eYSIP-2018/CNC-for-GrowBox/Codes_for_cnc/Codes_for_cnc/greenbox1.png

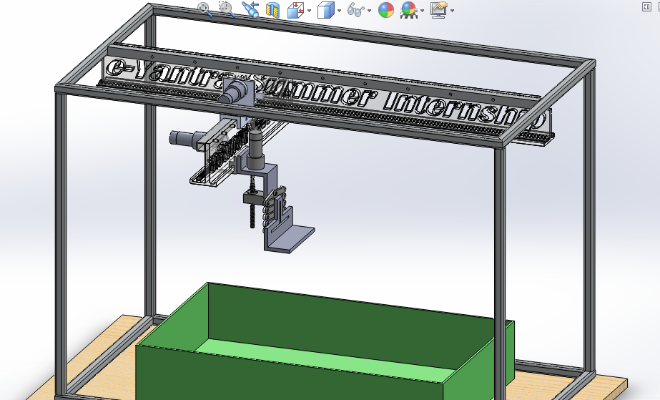
Codes_for_cnc/Codes_for_cnc/greenbox1.png
