eYSIP-2018/CNC-for-GrowBox/Codes_for_cnc/Codes_for_cnc/img03.jpg

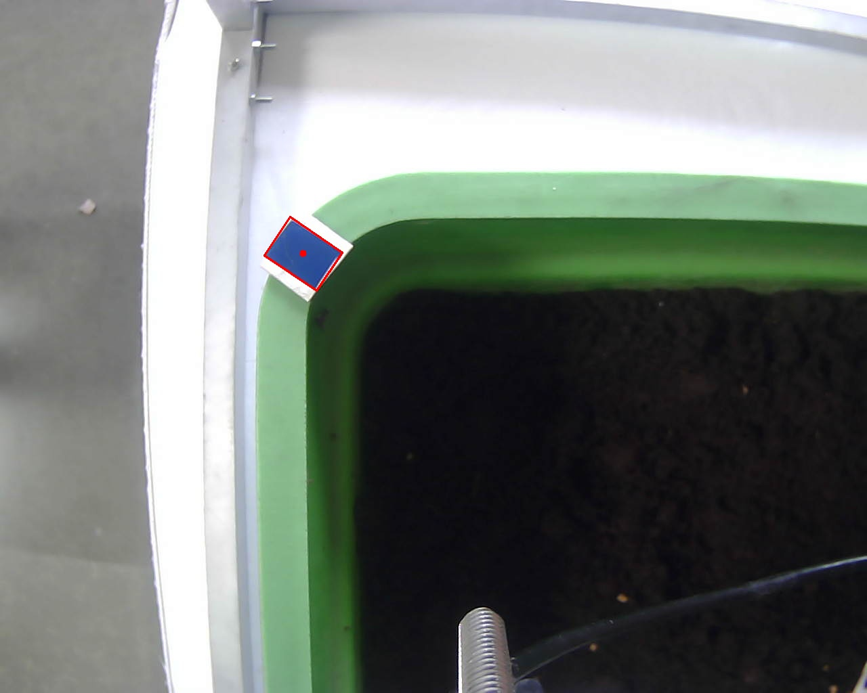
Codes_for_cnc/Codes_for_cnc/img03.jpg
