eYSIP-2018/CNC-for-GrowBox/final design/full assembly_v1.SLDASM

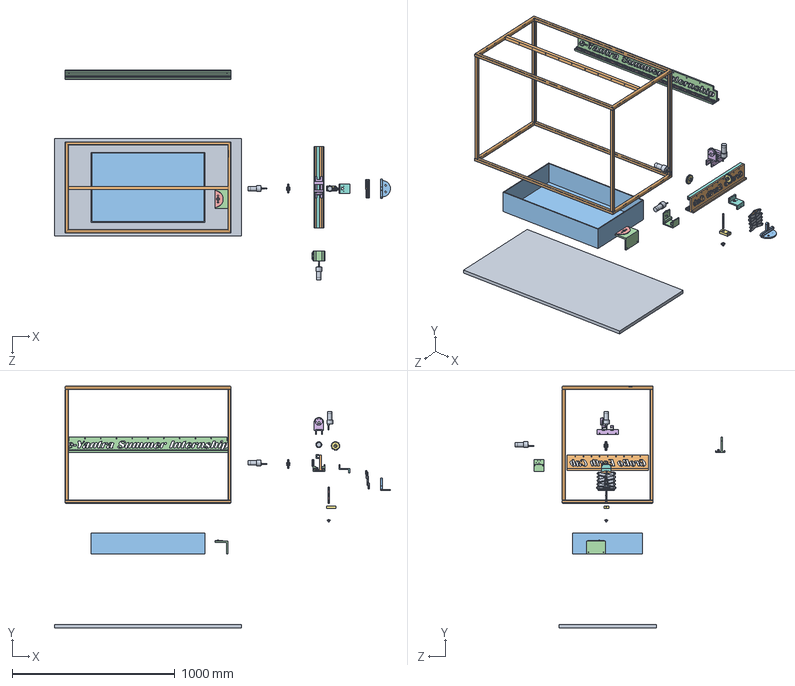
[picture p24: CAD file, 2018-07-06]
final design/full assembly_v1.SLDASM
2065.1 x 1485.8 x 1292.5 mm
floor
stand
trough
rail_x
Rack_x
servo_,mounting_x
pinion x 2
y_st_member
johnson motor x 3
rail_y
Rack_y
servo_,mounting_y
leadscrew
LeadScrew Nut 8mm x 2mmPitch
leadscrew nut attachment
attachment
link x 8
short link x 2
tool head
tool holder
watering tool
sprinkling plate
