eYSIP-2018/CNC-for-GrowBox/final design/fixed link.SLDPRT

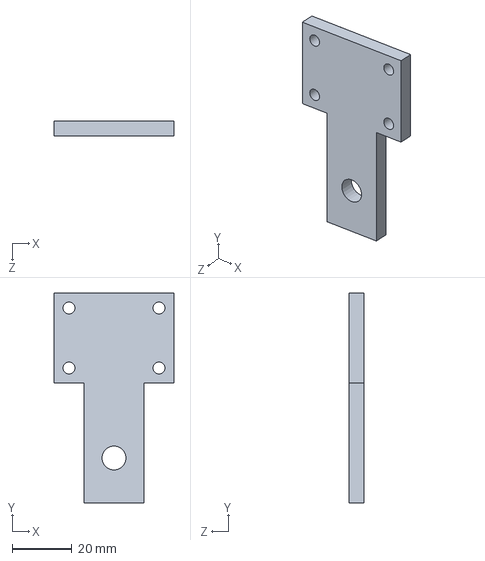
[picture p25: CAD file, 2018-07-06]
final design/fixed link.SLDPRT
40.0 x 70.0 x 5.00 mm
