eYSIP-2018/CNC-for-GrowBox/final design/Laser cutting/5_mm_changable.DXF

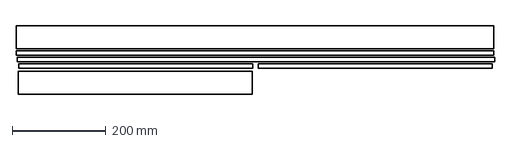
[picture p26: CAD file, 2018-07-06]
final design/Laser cutting/5_mm_changable.DXF
1022.3 x 147.4 mm
