eYSIP-2018/CNC-for-GrowBox/final design/Laser cutting/10_mm_y.SLDPRT

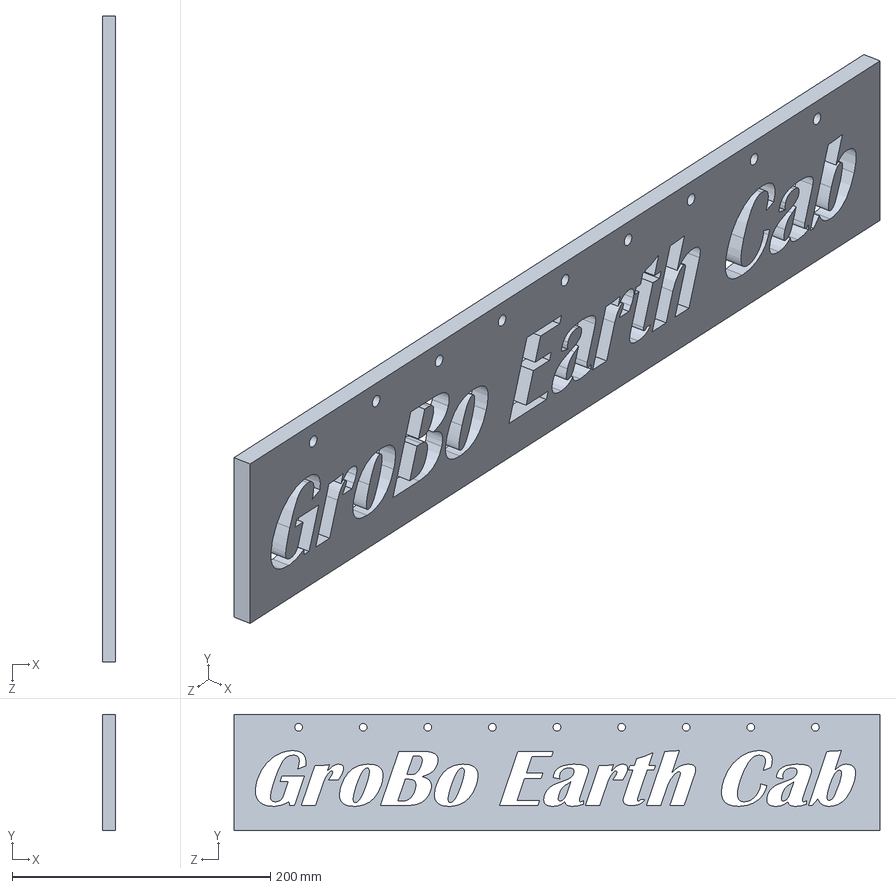
[picture p27: CAD file, 2018-07-06]
final design/Laser cutting/10_mm_y.SLDPRT
10.0 x 90.0 x 500.0 mm
