eYSIP-2018/CNC-for-GrowBox/final design/servo_,mounting_y.SLDPRT

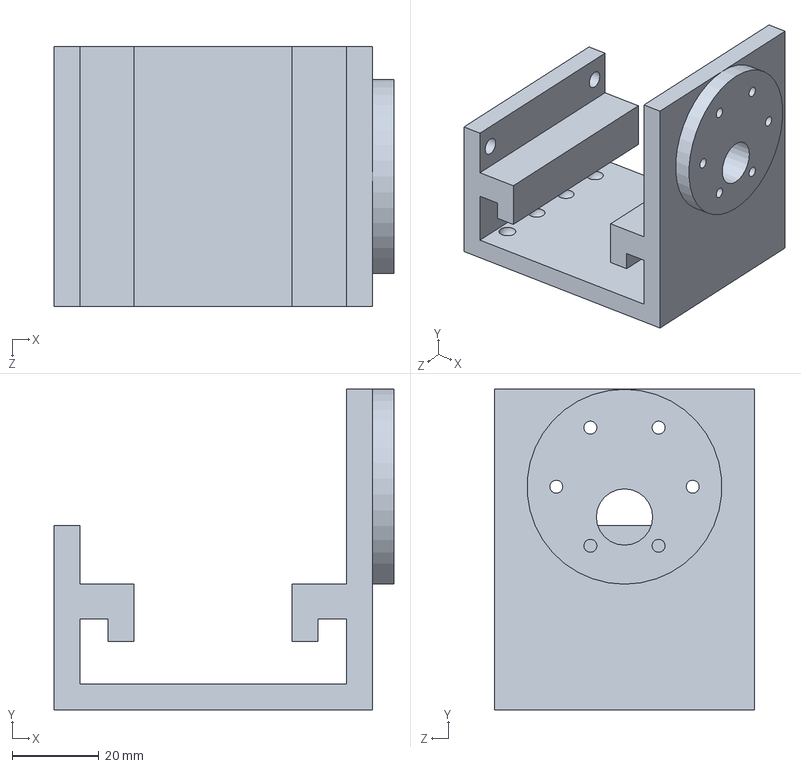
[picture p28: CAD file, 2018-07-06]
final design/servo_,mounting_y.SLDPRT
78.5 x 74.0 x 60.0 mm
