eYSIP-2018/CNC-for-GrowBox/final design/Laser cutting/Rack_y.SLDPRT

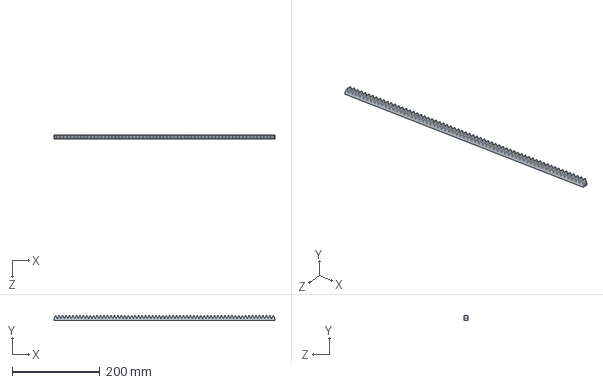
[picture p29: CAD file, 2018-07-06]
final design/Laser cutting/Rack_y.SLDPRT
502.7 x 11.2 x 10.0 mm
