eYSIP-2018/CNC-for-GrowBox/final design/tool holder.SLDPRT

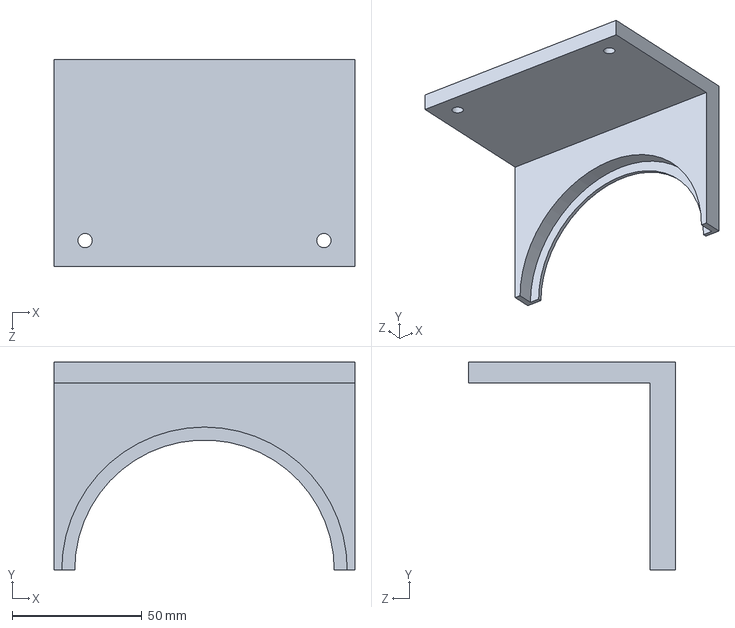
[picture p30: CAD file, 2018-07-06]
final design/tool holder.SLDPRT
116.0 x 80.0 x 79.8 mm
