eYSIP-2018/CNC-for-GrowBox/final design/Laser cutting/5mm_y_2.SLDPRT

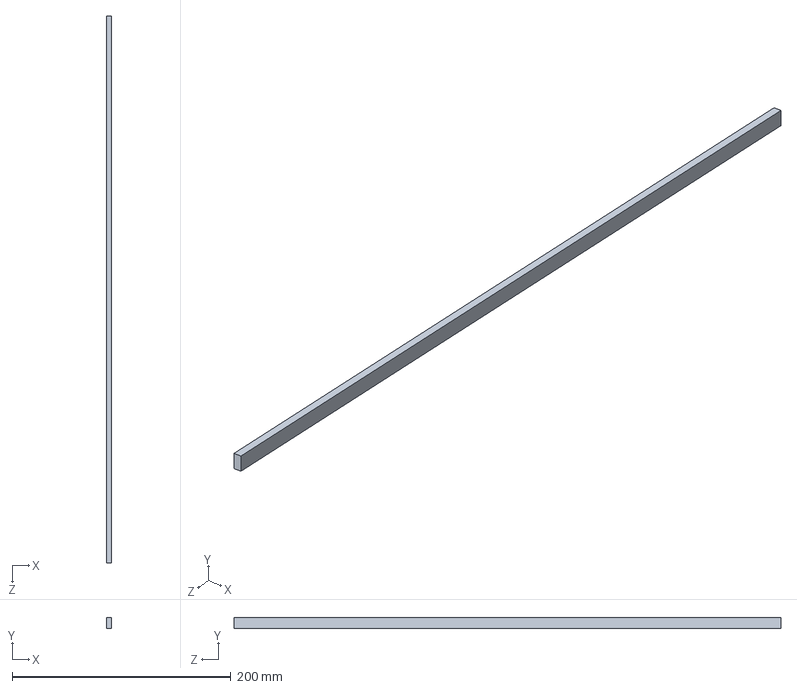
[picture p31: CAD file, 2018-07-06]
final design/Laser cutting/5mm_y_2.SLDPRT
5.00 x 10.0 x 500.0 mm
