eYSIP-2018/CNC-for-GrowBox/final design/male small link.SLDPRT

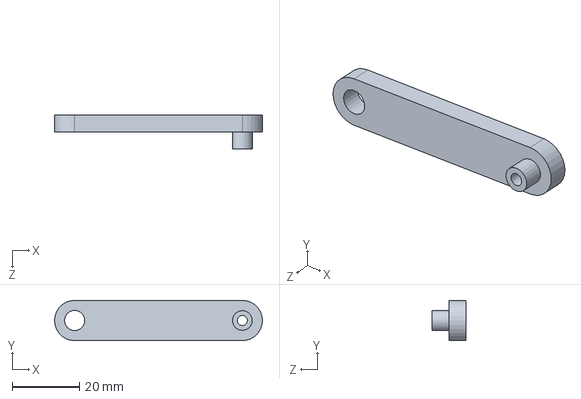
[picture p32: CAD file, 2018-07-06]
final design/male small link.SLDPRT
62.0 x 12.0 x 10.0 mm
