eYSIP-2018/CNC-for-GrowBox/final design/Laser cutting/10_mm_changable.DXF

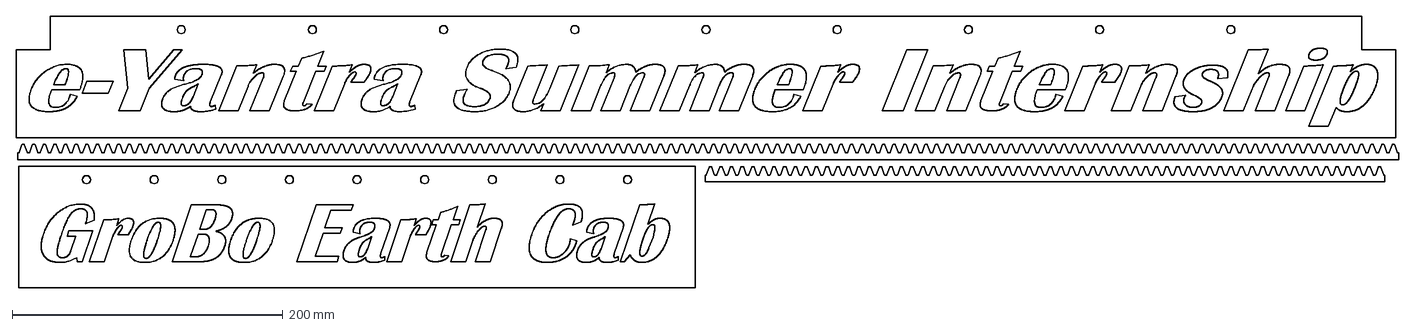
[picture p33: CAD file, 2018-07-06]
final design/Laser cutting/10_mm_changable.DXF
1022.2 x 200.9 mm
