eYSIP-2018/CNC-for-GrowBox/final design/watering tool.SLDPRT

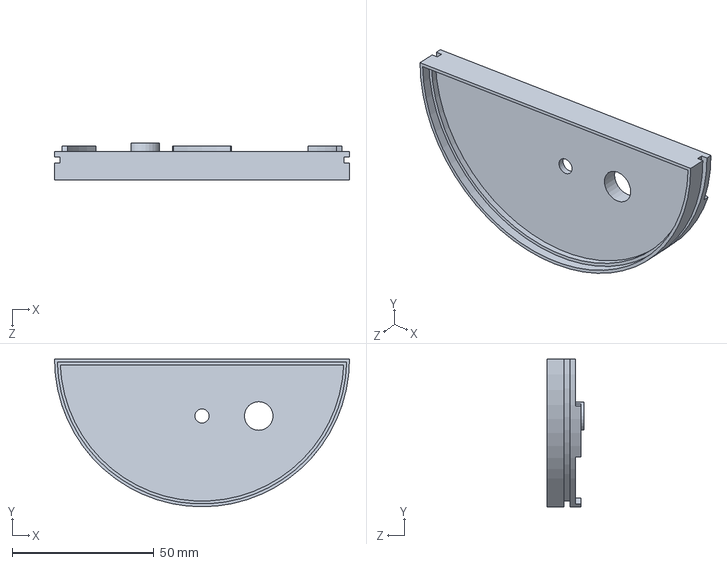
[picture p34: CAD file, 2018-07-06]
final design/watering tool.SLDPRT
104.0 x 52.0 x 13.0 mm
