eYSIP-2018/CNC-for-GrowBox/final design/Laser cutting/5_mm_final.DXF

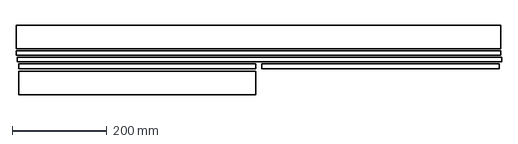
[picture p35: CAD file, 2018-07-06]
final design/Laser cutting/5_mm_final.DXF
1022.3 x 147.4 mm
