eYSIP-2018/CNC-for-GrowBox/final design/Laser cutting/10_mm_x.SLDPRT

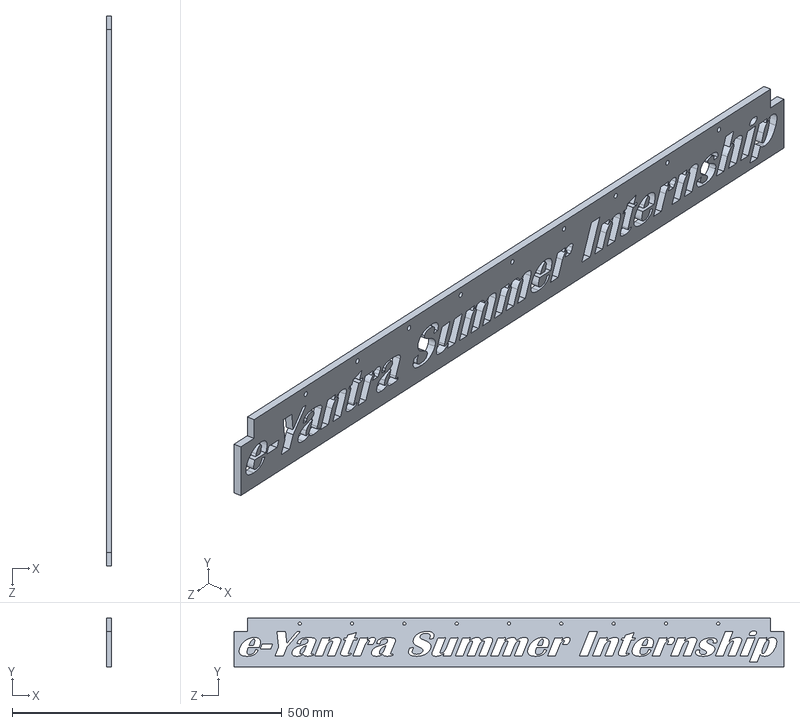
[picture p36: CAD file, 2018-07-06]
final design/Laser cutting/10_mm_x.SLDPRT
10.0 x 90.0 x 1020.0 mm
