eYSIP-2018/CNC-for-GrowBox/final design/Laser cutting/5_mm_x_2.SLDPRT

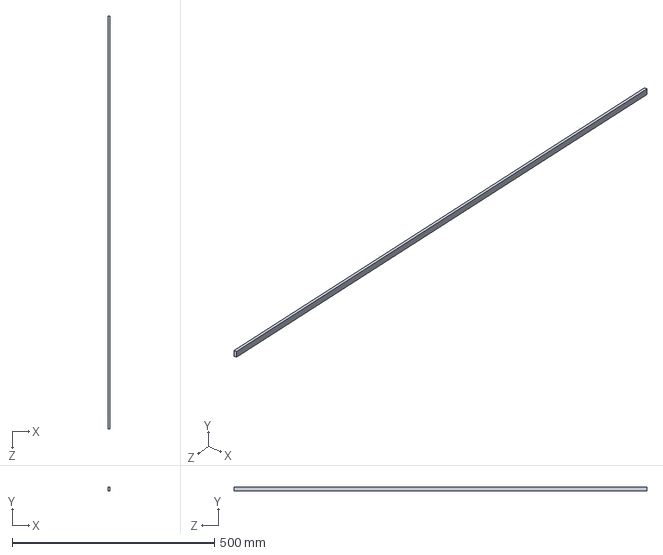
[picture p37: CAD file, 2018-07-06]
final design/Laser cutting/5_mm_x_2.SLDPRT
5.00 x 10.0 x 1020.0 mm
