eYSIP-2018/CNC-for-GrowBox/final design/pinion.SLDPRT

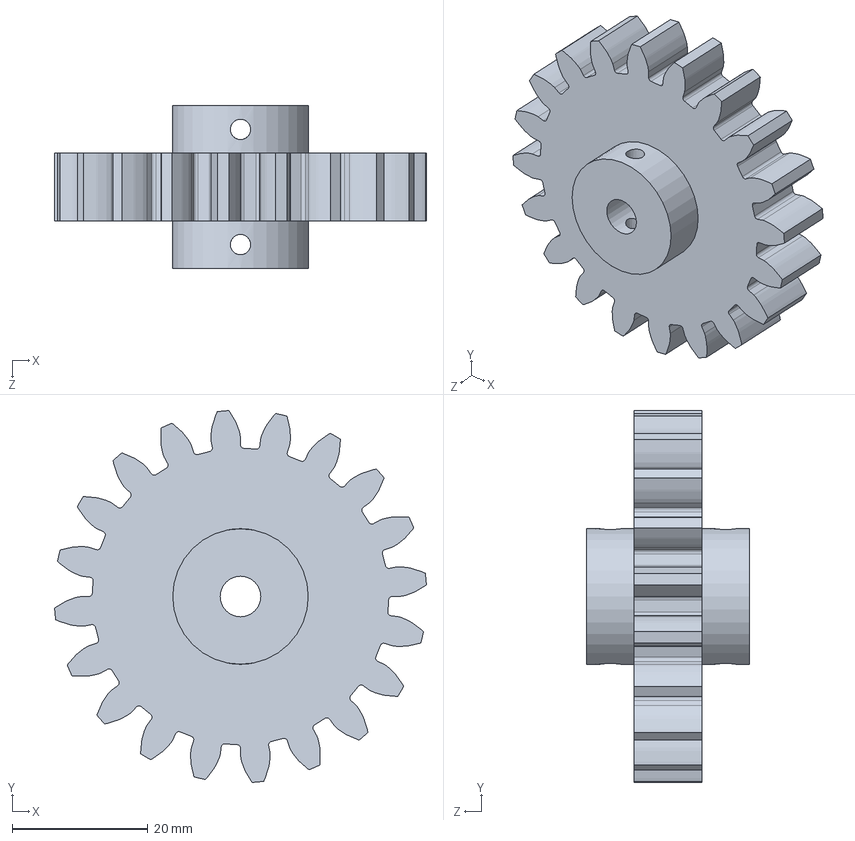
[picture p38: CAD file, 2018-07-06]
final design/pinion.SLDPRT
54.9 x 54.9 x 24.0 mm
