eYSIP-2018/CNC-for-GrowBox/final design/Laser cutting/Rack_x.SLDPRT

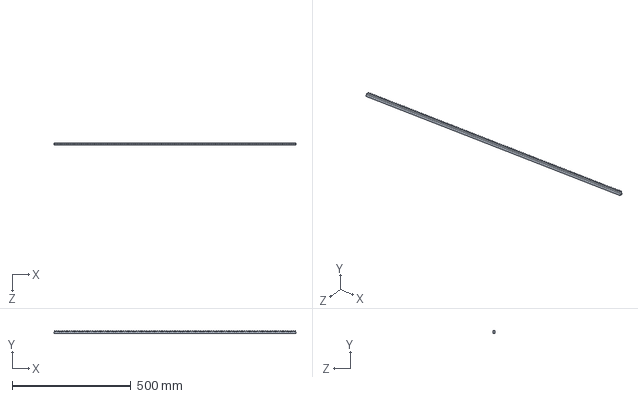
[picture p39: CAD file, 2018-07-06]
final design/Laser cutting/Rack_x.SLDPRT
1021.0 x 11.2 x 10.0 mm
