eYSIP-2018/CNC-for-GrowBox/final design/Laser cutting/5_mm_x_1.SLDPRT

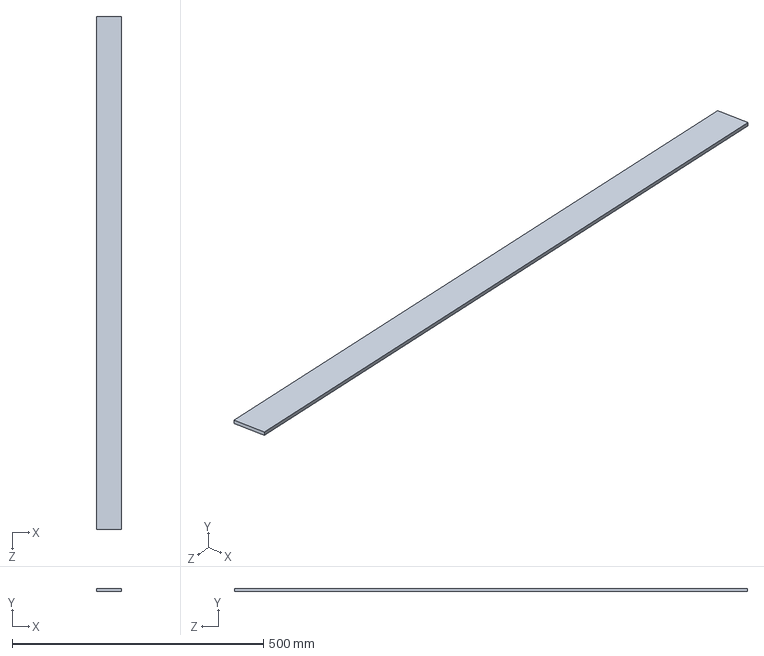
[picture p40: CAD file, 2018-07-06]
final design/Laser cutting/5_mm_x_1.SLDPRT
50.0 x 5.00 x 1020.0 mm
