eYSIP-2018/CNC-for-GrowBox/final design/male link.SLDPRT

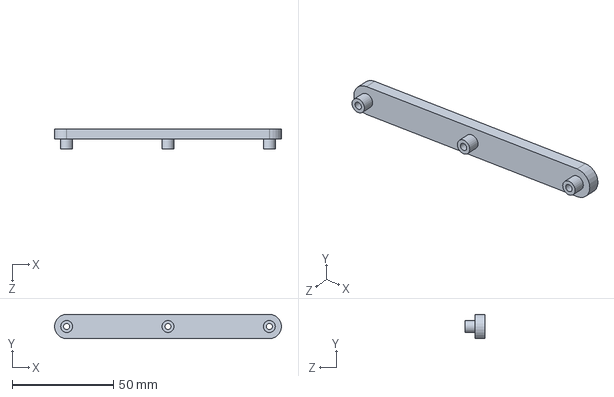
[picture p41: CAD file, 2018-07-06]
final design/male link.SLDPRT
112.0 x 12.0 x 10.0 mm
