eYSIP-2018/CNC-for-GrowBox/final design/Laser cutting/5mm_y_1.SLDPRT

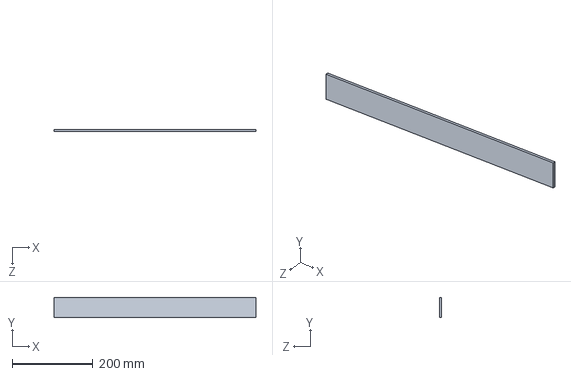
[picture p42: CAD file, 2018-07-06]
final design/Laser cutting/5mm_y_1.SLDPRT
500.0 x 50.0 x 5.00 mm
