eYSIP-2018/CNC-for-GrowBox/final design/stand.SLDPRT

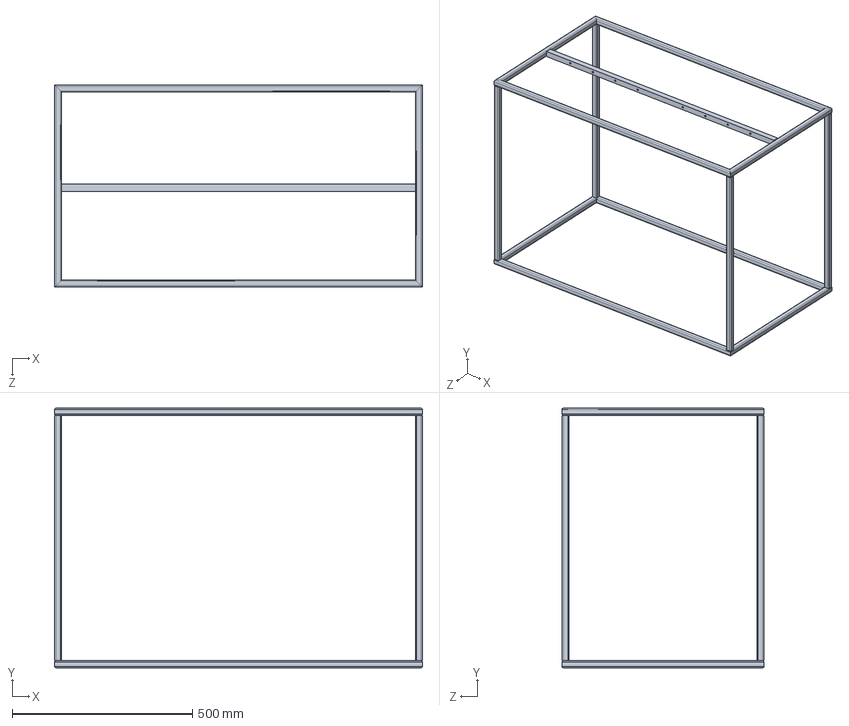
[picture p43: CAD file, 2018-07-06]
final design/stand.SLDPRT
1020.0 x 720.0 x 560.0 mm
