eYSIP-2018/CNC-for-GrowBox/final design/johnson motor.SLDPRT

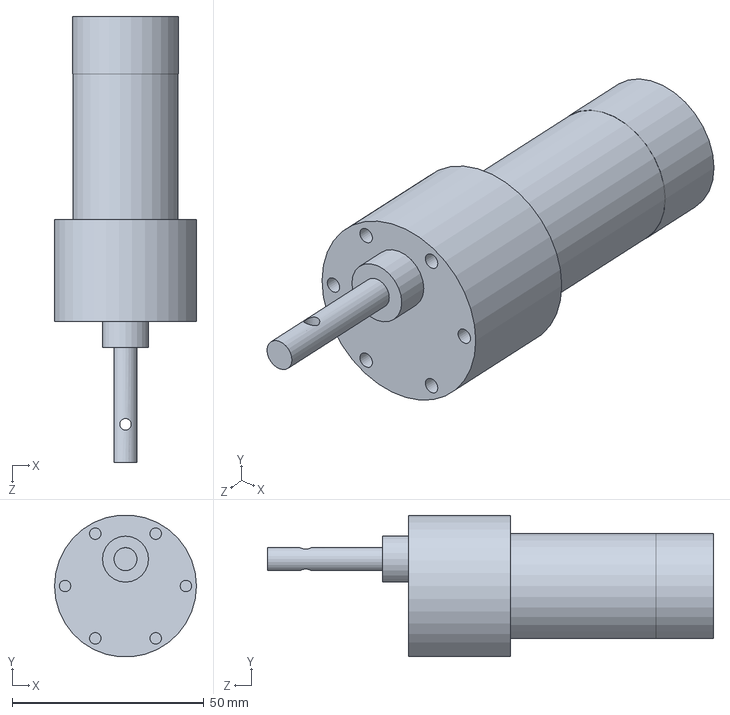
[picture p44: CAD file, 2018-07-06]
final design/johnson motor.SLDPRT
37.0 x 36.8 x 116.3 mm
