eYSIP-2018/CNC-for-GrowBox/final design/Laser cutting/scissors arm links.DXF

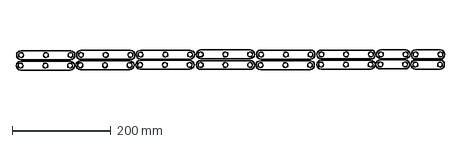
[picture p45: CAD file, 2018-07-06]
final design/Laser cutting/scissors arm links.DXF
866.7 x 41.1 mm
