eYSIP-2018/CNC-for-GrowBox/final design/floor.SLDPRT

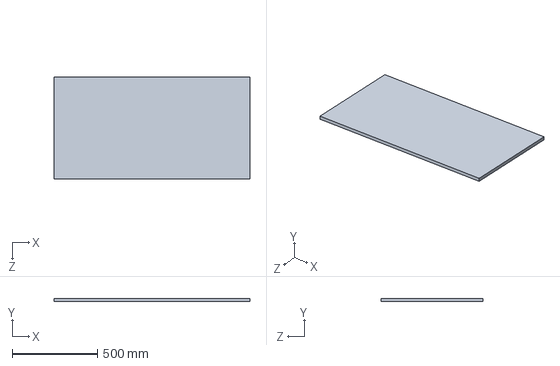
[picture p46: CAD file, 2018-07-06]
final design/floor.SLDPRT
1150.0 x 20.0 x 600.0 mm
