eYSIP-2018/CNC-for-GrowBox/final design/Laser cutting/10_mm_final.DXF

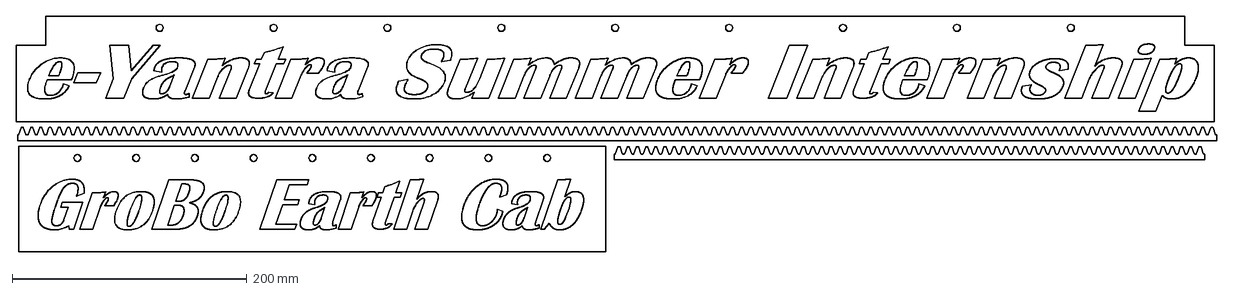
[picture p47: CAD file, 2018-07-06]
final design/Laser cutting/10_mm_final.DXF
1022.2 x 200.9 mm
