eYSIP-2018/CNC-for-GrowBox/final design/tool head.SLDPRT

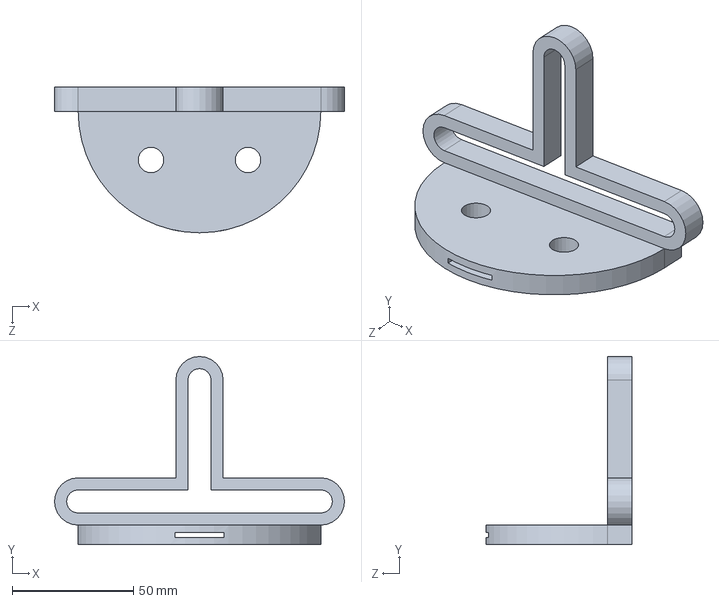
[picture p48: CAD file, 2018-07-06]
final design/tool head.SLDPRT
119.5 x 77.5 x 60.0 mm
