eYSIP-2018/CNC-for-GrowBox/final design/link.SLDPRT

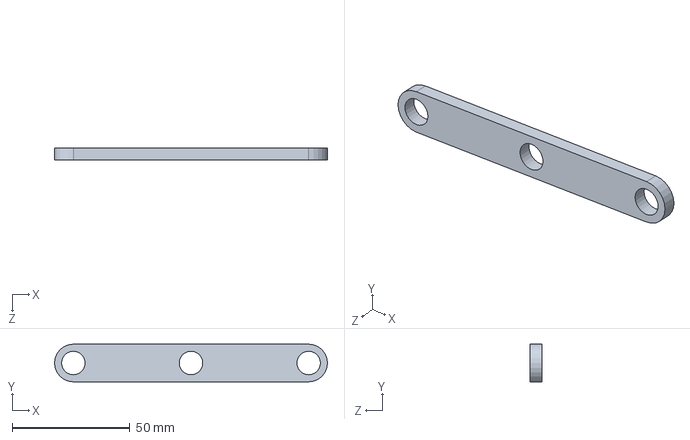
[picture p49: CAD file, 2018-07-06]
final design/link.SLDPRT
116.0 x 16.0 x 5.00 mm
