eYSIP-2018/CNC-for-GrowBox/final design/rail_y.SLDPRT

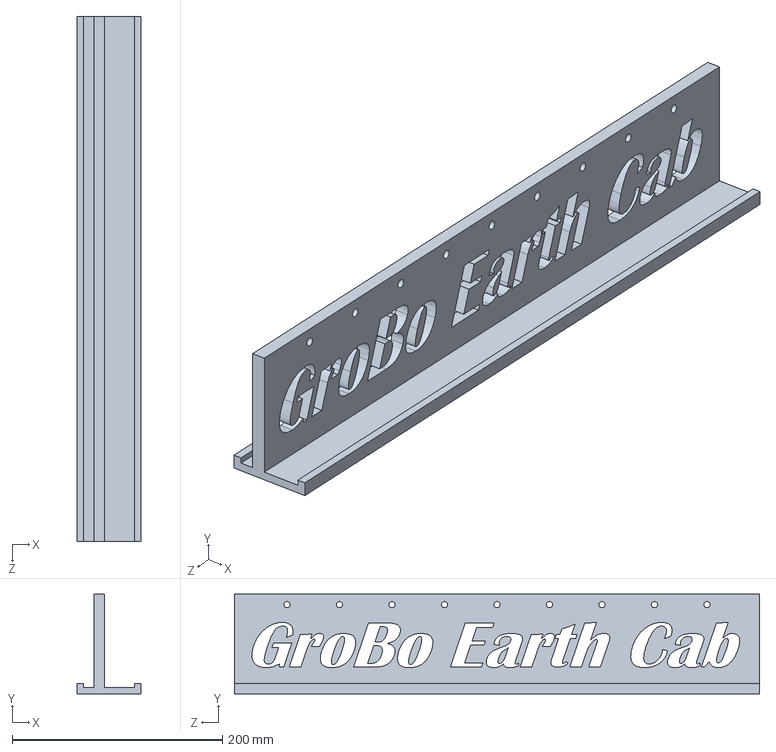
[picture p50: CAD file, 2018-07-06]
final design/rail_y.SLDPRT
60.8 x 95.0 x 500.0 mm
