eYSIP-2018/CNC-for-GrowBox/final design/trough.SLDPRT

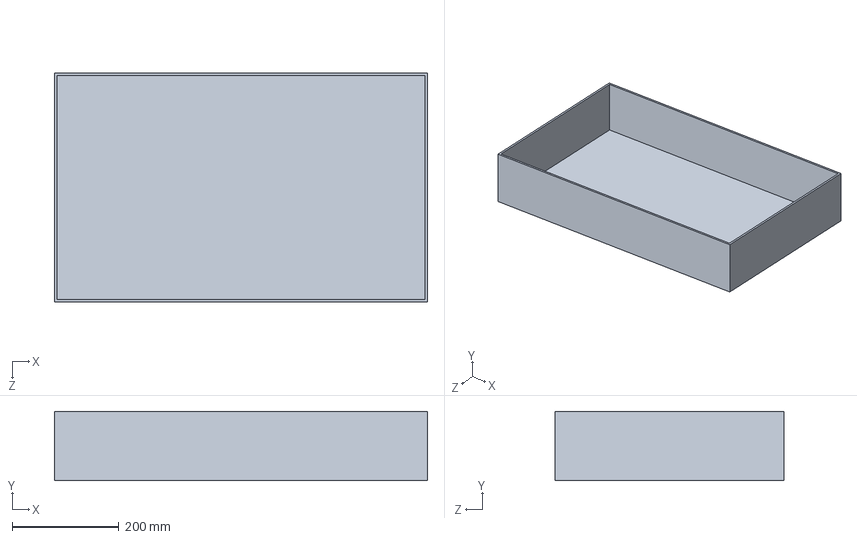
[picture p51: CAD file, 2018-07-06]
final design/trough.SLDPRT
700.0 x 130.0 x 430.0 mm
