eYSIP-2018/CNC-for-GrowBox/final design/servo_,mounting_x.SLDPRT

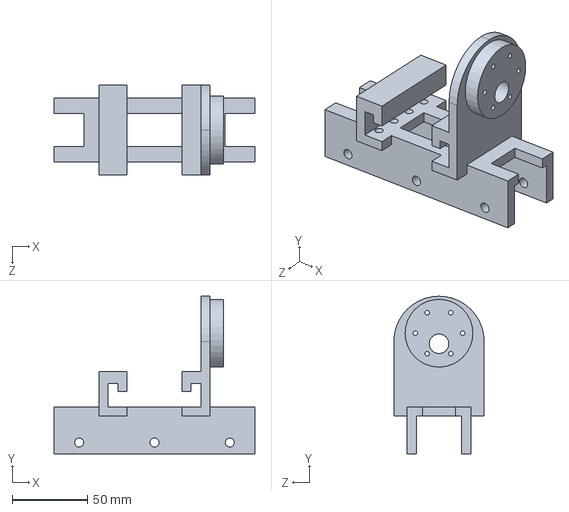
[picture p52: CAD file, 2018-07-06]
final design/servo_,mounting_x.SLDPRT
133.5 x 104.7 x 60.0 mm
