eYSIP-2018/CNC-for-GrowBox/final design/y_st_member.SLDPRT

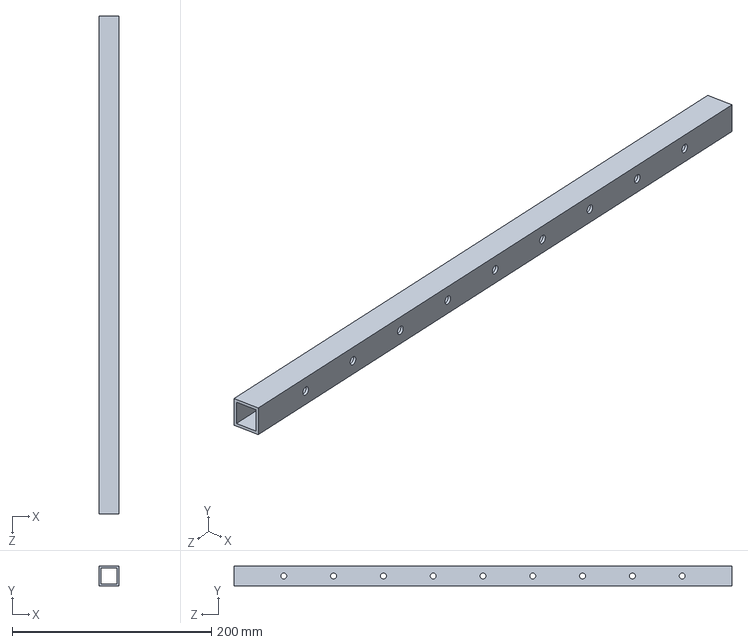
[picture p53: CAD file, 2018-07-06]
final design/y_st_member.SLDPRT
20.0 x 20.0 x 500.0 mm
