eYSIP-2018/CNC-for-GrowBox/final design/short link.SLDPRT

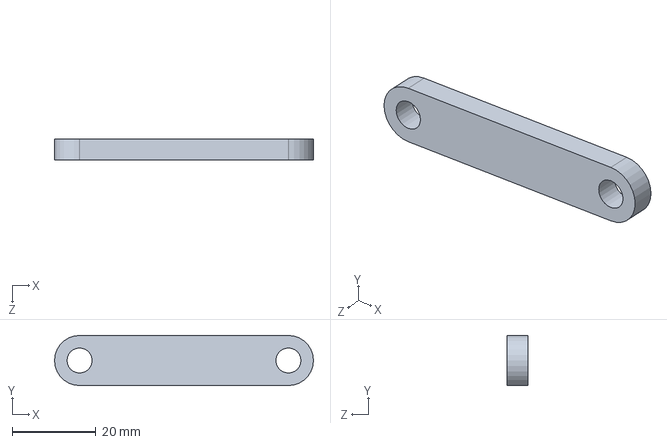
[picture p54: CAD file, 2018-07-06]
final design/short link.SLDPRT
62.0 x 12.0 x 5.00 mm
