eYSIP-2018/CNC-for-GrowBox/final design/attachment.SLDPRT

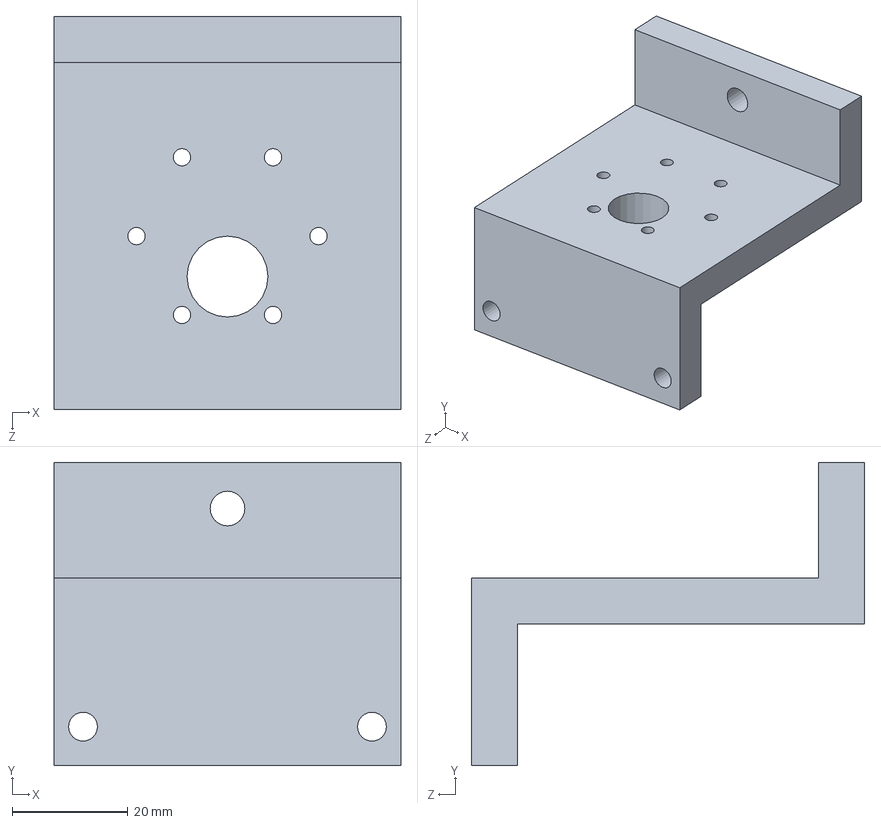
[picture p55: CAD file, 2018-07-06]
final design/attachment.SLDPRT
60.0 x 52.5 x 68.0 mm
