eYSIP-2018/CNC-for-GrowBox/final design/rail_x.SLDPRT

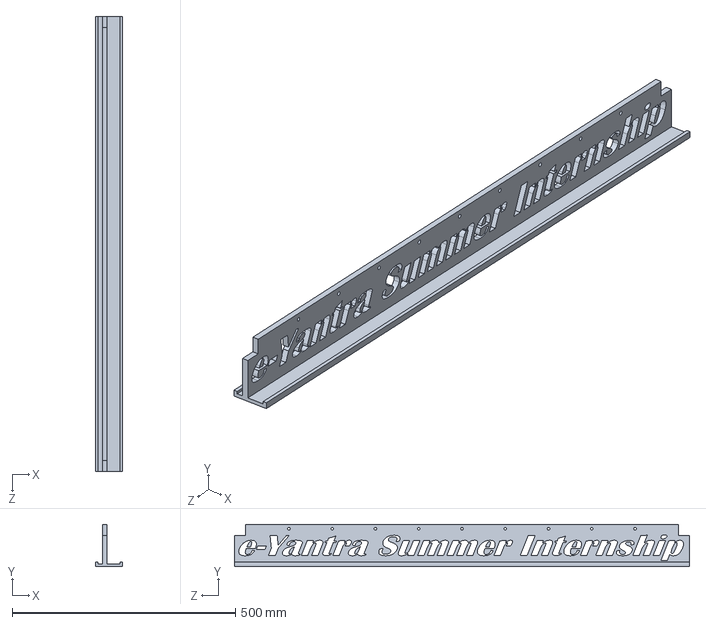
[picture p56: CAD file, 2018-07-06]
final design/rail_x.SLDPRT
60.8 x 95.0 x 1020.0 mm
