eYSIP-2018/CNC-for-GrowBox/final design/sprinkling plate.SLDPRT

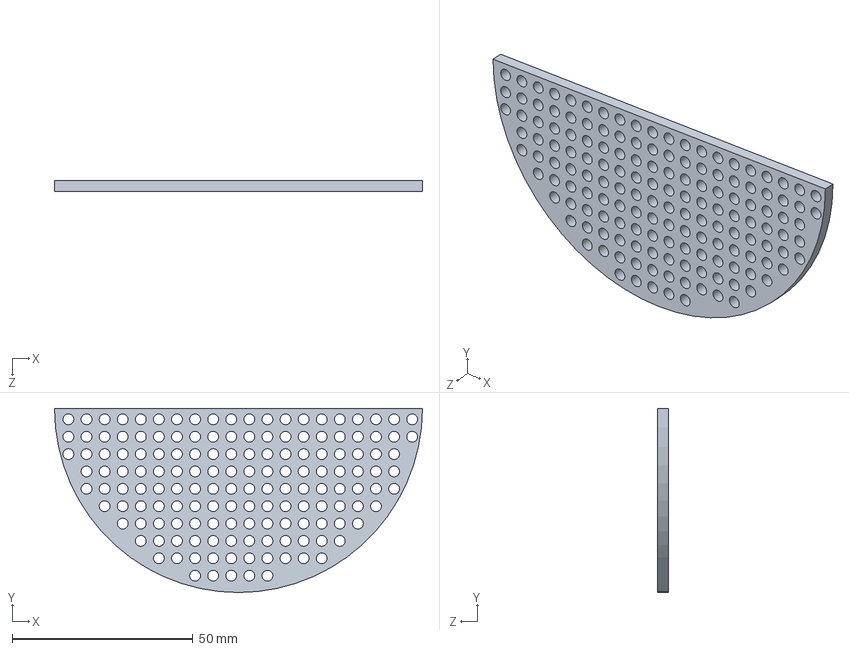
[picture p58: CAD file, 2018-07-06]
final design/sprinkling plate.SLDPRT
101.7 x 50.8 x 3.00 mm
