eYSIP-2018/CNC-for-GrowBox/(list of files, cad)

Other CAD files:
final design/seeding tool.SLDPRT
final design/Laser cutting/10_mm.SLDDRW
final design/Laser cutting/10_mm_changable.SLDDRW
final design/Laser cutting/5_mm.SLDDRW
final design/Laser cutting/5_mm_changable.SLDDRW
final design/Laser cutting/scissors arm links.SLDDRW
final design/LeadScrew Nut 8mm x 2mmPitch.SLDPRT
final design/leadscrew nut attachment.SLDPRT
final design/leadscrew.SLDPRT
final design/single leadscrew mechanism.SLDASM
