eYSIP-2018/CNC-for-GrowBox/final design/Laser cutting/10_mm_changable.PDF

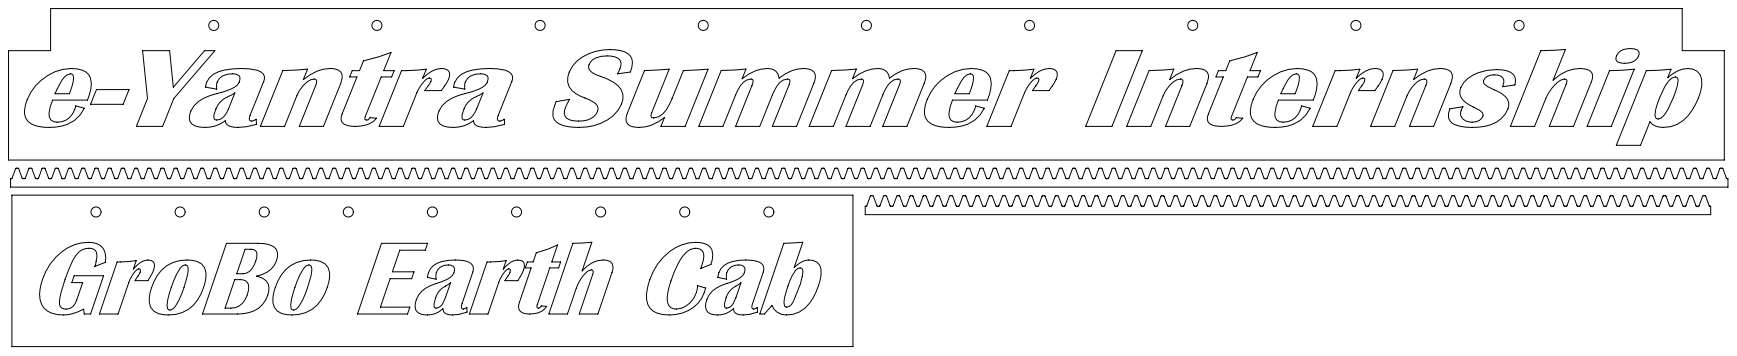
[picture p59: page 1]
