eYSIP-2018/CNC-for-GrowBox/final design/Laser cutting/5_mm_changable.PDF

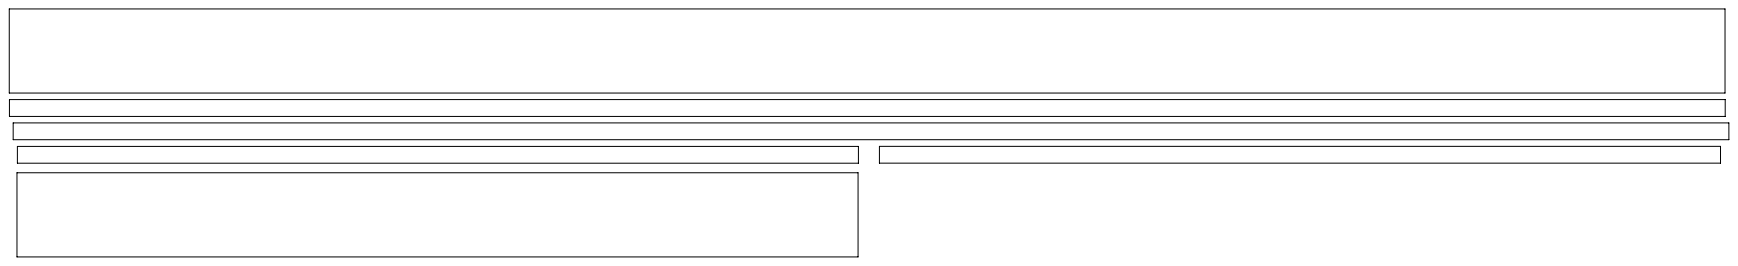
[picture p60: page 1]
