eYSIP-2018/CNC-for-GrowBox/(list of files, drawings)

Other design files:
circuit schematic/circuit_diagram.fzz
