eYSIP-2018/CNC-for-GrowBox/(commit log)

2018-07-01 new approach to reduce error
    [new_main_new_approach.ino]
2018-07-02 final arduino code
2018-07-06 most final design
    [10_mm.SLDDRW, 10_mm_changable.DXF, 10_mm_changable.SLDDRW, 10_mm_final.DXF, 10_mm_x.SLDPRT, 10_mm_y.SLDPRT, 5_mm.SLDDRW, 5_mm_changable.DXF]
2018-07-06 circuit schematic
    [circuit_diagram.fzz]
